mehash32/Water-level-monitoring-system/(list of files, drawings)

Other design files:
water_level_test_ project.pdsprj
